JacobKellyobrien/Magnetometer_Arduino_Project/(commit log)

2024-10-16 Added Arduino Code
2024-10-17 Good Magnetometer code cleaned up
2025-02-11 Magnetometer Manual
